Ahmedvini/fpga-atcnet/sim/db_atcnet_axi_tb.sv

// =============================================================================
// db_atcnet_axi_tb.sv  —  Lightweight sanity tests for the deployment
// wrapper rtl/db_atcnet_axi.sv. Verifies:
//
//   1. AXI-Lite reads of STATUS / CLASS work (idle-state values).
//   2. AXI-Stream handshake accepts a small burst of raw EEG beats.
//   3. AXI-Lite write to GUMBEL_LUT actually lands in the adapter's LUT
//      (read-back via observing match behaviour on the AXIS path).
//
// The full data-path is exercised by sim/db_atcnet_top_tb.sv (which goes
// through the same db_atcnet_top instance the wrapper holds); this test
// keeps the run-time short while proving the plumbing works.
// =============================================================================

`timescale 1ns / 1ps

module db_atcnet_axi_tb;

    localparam int CLK_PERIOD = 10;
    logic clk = 0;
    initial forever #(CLK_PERIOD/2) clk = ~clk;
    logic rst;

    // AXIS
    logic [31:0]  s_axis_tdata;
    logic         s_axis_tvalid;
    logic         s_axis_tready;
    logic         s_axis_tlast;
    // AXI-Lite
    logic [31:0]  s_axi_awaddr;
    logic         s_axi_awvalid;
    logic         s_axi_awready;
    logic [31:0]  s_axi_wdata;
    logic [3:0]   s_axi_wstrb;
    logic         s_axi_wvalid;
    logic         s_axi_wready;
    logic [1:0]   s_axi_bresp;
    logic         s_axi_bvalid;
    logic         s_axi_bready;
    logic [31:0]  s_axi_araddr;
    logic         s_axi_arvalid;
    logic         s_axi_arready;
    logic [31:0]  s_axi_rdata;
    logic [1:0]   s_axi_rresp;
    logic         s_axi_rvalid;
    logic         s_axi_rready;
    logic         irq_done;
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
