Ahmedvini/fpga-atcnet/(commit log)

2026-05-18 Pivot to HaLT subject-dependent variant; clean placeholder skeleton
    Architectural change from the AI team: model swapped from the subject-
    independent 4-class PhysioNet .h5 to a subject-dependent HaLT variant
    (5 input channels Gumbel-selected from 19 EEG, 600 samples @ 200 Hz,
    2 classes — right-hand fist vs left-leg ankle). Improved CBAM attention
    everywhere (no MHA); per-window weights are now INDEPENDENT, not shared.
    Removed (all dead under the new model):
    - rtl/top.sv, top_backup.sv, top_resource_eval.sv, integrated_example.sv
    (5-tap FIR demo, never DB-ATCNet)
    - rtl/conv/temporal_conv.sv, temporal_conv_backup.sv (placeholder FIR)
    - rtl/conv/dual_branch_conv.sv, channel_scale.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
    [conv2d_temporal.sv, conv2d_temporal_tb.sv, eca_attention.sv, eeg_channel_adapter.sv]
2026-05-18 Layer 1 (Conv2D temporal) PASS bit-exact on HaLT shape
    - rtl/db_atcnet_params.svh: rewritten for HaLT dims (NUM_INPUT_CH=5,
    TRIAL_SAMPLES=600, NUM_CLASSES=2, KE=64, F1=16, F2=32, POOL1=8,
    POOL2=7, NUM_WINDOWS=5, WIN_LEN=6, CBAM_RATIO=8, SPATIAL_KE=7,
    TCN depth=2 k=4, etc.)
    - scripts/q88_layer1.py: HaLT (5x600) Q8.8 reference. Loads conv2d
    weights from weights/subject_A/session_3_heldout/best_model.weights.h5.
    Synthetic deterministic 5-channel input.
    - data/golden_q88/stage_conv2d_*.hex regenerated for the new shape.
    abs_max=277 (way under Q8.8 limit of 32767), zero saturation.
    - sim/conv2d_temporal_tb.sv: NUM_EEG_CH 64->5, TRIAL_SAMPLES 640->600.
    - conv2d_temporal_tb result: 3000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
2026-05-18 Fold BatchNorm into Layer 1 Conv2D (Layers 1+2 fused, PASS bit-exact)
    BN at inference is a per-channel affine transform:
    y = gamma * (x - mean) / sqrt(var + eps) + beta
    Folding it into the preceding Conv2D collapses Layers 1+2 into a single
    hardware op (saves an RTL stage and a BRAM-traffic round trip):
    w_folded[k,f] = w[k,f] * gamma[f]/sqrt(var[f]+eps)
    bias_folded[f] = beta[f] - mean[f] * gamma[f]/sqrt(var[f]+eps)
    Changes:
    * scripts/q88_layer1.py: loads BN params from batch_normalization layer in
    .h5, computes folded weights + per-filter bias, emits both as .mem.
    Now produces stage_conv2d_bias.hex (16 Q8.8 values) alongside the
    folded stage_conv2d_weights.hex.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
2026-05-18 Layer 3 (ECA₁) PASS bit-exact + sigmoid LUT infrastructure
    Adds the gate-compute path for ECA (Efficient Channel Attention),
    shared by ECA₁ (16 ch) and ECA₂ (32 ch). Includes the universal
    sigmoid LUT used everywhere a real sigmoid is needed (ECA, CBAM
    channel gate, etc.).
    Sigmoid LUT (universal, baked into bitstream):
    * scripts/gen_sigmoid_lut.py — emits data/lut/sigmoid_q88.hex.
    Default LUT_RANGE = ±4.0, N = 1024 entries, addr-shift = 1.
    Output values: 5..251 in Q8.8 (sigmoid(±4) ≈ 0.018..0.982).
    Center entries: 0x80 = 0.5.
    * Same LUT used by Python golden (scripts/q88_eca1.py) and the
    RTL module so bit-exact is guaranteed by construction.
    ECA₁ Python re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
2026-05-18 ECA₁ complete end-to-end: GAP accumulator + gate_apply PASS bit-exact
    This closes Layer 3 (ECA₁) into a deployable three-module pipeline:
    streaming feature map → GAP → gate-compute → re-stream + gate-apply.
    Layer 1+2 output ──► gap_accumulator ──► (16-wide GAP vector)
    │ │
    │ ▼
    │ eca_attention ← weights + σ-LUT
    │ │
    │ ▼
    └─► (re-streamed) ──► gate_apply ──► (gated feature map)
    Top-level integration (next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
2026-05-18 Layer 4 (Branch A depthwise + BN folded) PASS bit-exact
    DepthwiseConv2D(kernel=(1,5), depth_multiplier=2, no bias) + BatchNorm
    collapsed into a single hardware op via BN folding. This is the first
    stage of Branch A; the gated feature map from ECA₁ collapses across
    the 5 electrodes here, producing 32 channels per time step.
    Math (matches scripts/q88_layer4.py bit-exactly):
    For each output channel i = f*D + d (f∈[0,F1), d∈[0,D)):
    y[t, i] = sat( ( sum_{c=0..4} x[t, c, f] * W_folded[c, f, d] )
    >>> FRAC_BITS + bias_folded[i] )
    BN-fold formulas reused from Layer 1+2:
    scale[i] = gamma[i] / sqrt(var[i] + eps)
    bias[i] = beta[i] - mean[i] *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
2026-05-18 Layers 5+6 (ELU LUT + temporal AvgPool) PASS bit-exact
    Two small but essential building blocks complete:
    ELU activation (Layer 5):
    * scripts/gen_elu_lut.py — 256-entry Q8.8 LUT for the negative half of
    ELU. For x≥0 the value passes through; for x<0 the address is
    ((-x) >> 3) clipped to [0, 255], indexing α(exp(x)-1). For
    alpha=1.0 (Keras default), output range is [-1.0, ~0).
    * scripts/q88_layer5.py — applies the LUT to the Branch A depthwise
    output to produce stage_branchA_elu_output.hex.
    * rtl/conv/elu.sv — parameterized N-channel ELU module with 1-cycle
    latency. Pass-through path for positives; LUT lookup for negatives
    with combinational clip + addr.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
2026-05-18 Layers 8 + 9 (Branch A: ELU on sep + AvgPool(7,1)) PASS bit-exact
    Both layers reuse existing RTL modules — Layer 8 is a second
    instantiation of rtl/conv/elu.sv (no new RTL); Layer 9 is a
    re-parameterization of rtl/conv/avg_pool_time.sv with POOL=7
    (INV_POOL=2396745, shift=24).
    New artefacts:
    * scripts/q88_layer8_9.py — applies the ELU LUT to the Branch A
    separable output (Layer 8), then runs AvgPool(7,1) on the first
    70 of 75 ELU outputs to produce 10 final Branch A outputs (Layer 9).
    The last 5 ELU outputs are dropped by Keras' valid-padding stride-7
    pool — we drive exactly 70 inputs into the RTL pool block.
    * sim/avg_pool_time_7_tb.sv — drives the 70 vectors of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
2026-05-18 Branch B (Layers 10-14) PASS bit-exact — D=4 / F_IN=64 reuse existing modules
    dwise_b: 600/600 vectors, 0 mismatches (depthwise D=4 + BN_2 folded)
    sep_b: 75/75 outputs, 0 mismatches (separable F_IN=64 + BN_4 folded)
    Same RTL modules as Branch A (depthwise_spatial.sv, conv1d_temporal.sv),
    only parameters changed. Adds q88_branchB.py Python golden chain
    and two param-specific testbenches.
2026-05-18 Layer 16 (ECA₂) PASS bit-exact — integrated GAP+Conv1D+sigmoid+gate on (10,32)
    eca2_tb: 10/10 vectors, 0 mismatches. Reuses gap_accumulator,
    eca_attention, and gate_apply modules with NUM_CH=32, KECA=3,
    INV_N=1677722 (=round(2^24/10)). Weights from layers/conv1d_1
    in the trained subject_A session_3 model.
2026-05-18 ImprovedCBAM channel attention (window 0) PASS bit-exact
    chan_tb: 6/6 vectors, 0 mismatches.
    Implements doc §5.2.1 channel-attn for ATCNet sliding window 0:
    avg+max GAP (T=6) → shared MLP Dense(4)+ReLU+Dense(32)
    → Add → sigmoid LUT → per-channel gate apply.
    Parametric (NUM_CH, T_WIN, D_RED) so the same module slots in for
    all 5 windows once dense_{i,i+5} weight files are generated.
    Two SV lessons learned and applied:
    * signed × literal needs explicit $signed cast on the literal,
    otherwise mixed-sign multiply contaminates negative inputs.
    * bit-slicing a `logic signed` strips signedness; comparisons
    against `SAT_HI[15:0]` were interpreted unsigned and falsely
    t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
2026-05-18 ImpCBAM spatial attn — Q8.8 Python golden for window 0
    Computes avg/max/stochastic descriptors over the 32 channels,
    concatenates → Conv2D(7,7,3,1) (same padding) → sigmoid LUT →
    per-time gate apply. Stochastic pool is deterministic at inference:
    probs[t,c] = |x[t,c]| / max(sum_c |x[t,c]|, eps_q88=1)
    out[t] = sum_c probs[t,c] * x[t,c]
    Conv2D with kernel (7,7) on input width 1 collapses to a 7-tap 1D
    conv over T using the kw=3 (center) column of the 2D kernel; the
    other 42 weights multiply zero-padding and are stored only for
    provenance with the trained .h5.
    Window 0 uses layers/conv2d_3. Other windows use conv2d_{3+w}.
2026-05-18 ImpCBAM spatial stochastic-pool: switch to HW-aligned formulation
    Replace 192-per-window per-element divisions with one floor-div per
    time step (inv_norm = (1<<24)/norm). Then multiply per-channel and
    sum-accumulate. Output identical to within ±1 LSB of the original
    elementwise-floor formulation, but maps cleanly to a single
    serial divider amortised over 6 timesteps per window.
2026-05-18 Add radix-2 restoring serial divider + sanity TB
    rtl/util/serial_divider.sv: unsigned floor-div with start/done
    handshake. Latency = Q_WIDTH+2 cycles. Wired up generically
    (N_WIDTH, D_WIDTH, Q_WIDTH parameters). Caller must guarantee
    denominator != 0 (e.g. stoch-pool floors |x|-sum to 1).
    Will be used by the ImpCBAM spatial attention stochastic pool
    (1 div per timestep × 6 timesteps × 5 windows = 30 divs per
    inference, ~1k cycles total — negligible at 100 MHz).
2026-05-18 TCFN (window 0) PASS bit-exact — 4 causal dilated Conv1D + BN + ELU + 3 residuals
    tcfn_tb: 6/6 vectors, 0 mismatches.
    Single FSM that reuses one F_IN-parallel MAC bank across all 4 conv
    stages (dilations 1,1,2,2). 768 cycles per conv → 3072 per TCFN.
    BN is pre-folded into the conv weights/bias in the Python golden;
    Stage 1's Residual-2 has no terminal ELU per the spec.
    Q8.8 saturation accepted (per user); both Python and RTL clip
    identically so the test stays bit-exact even when stage 2/3
    accumulator hits ±32767.
    Two traps caught:
    * Causal-conv tap convention: tap k=0 is the most recent input
    (no lookback), k=K-1 the oldest. My `back` formula was using
    (K-1-k)*d (Keras kern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
2026-05-18 Dense(2) classifier + output head (avg+argmax) PASS
    dense_tb: bit-exact logits [302, -303] for window-0 TCFN last-step input.
    head_tb : sums 5 logit pairs and argmaxes correctly (sanity, no h5 needed).
    Output head skips the explicit divide-by-N_WIN and softmax because
    argmax(mean) == argmax(sum) for monotonic positive N. Tie-break favours
    the lower class index, matching numpy's argmax default.
    [dense_classifier.sv, dense_classifier_tb.sv, output_head.sv, output_head_tb.sv]
2026-05-18 cbam_channel_attn: handle back-to-back frames + 5-window TB PASS
    Previous frame_last reset path reloaded the accumulator with the
    current x_in, leaving stale data that polluted the next frame's
    first accumulate step. New `frame_started` flag tracks per-frame
    ingestion: on the first x_valid of a fresh frame we reset acc to
    x_in; subsequent x_valid cycles accumulate; frame_last drops the
    flag so the next window starts clean again.
    chan_w0 (N_WIN=1) still bit-exact PASS.
    chan_all (N_WIN=5) NEW TB walks window_idx 0..4 through the all_chan_*.hex
    combined weight banks → 30/30 vectors, 0 mismatches across all 5 windows.
    [cbam_channel_attn.sv, cbam_channel_attn_all_tb.sv]
2026-05-18 spat + tcfn 5-window TBs PASS bit-exact
    cbam_spatial_attn: S_READY now auto-exits to S_IDLE after the last
    apply_valid pulse, so the next window's first x_valid starts a clean
    frame (previously the FSM stuck in S_READY indefinitely).
    tcfn already returns to S_IDLE via S_DONE → S_IDLE — no FSM change
    needed for back-to-back frames.
    spat_all and tcfn_all walk window_idx 0..4 through the combined
    weight banks. 30/30 vectors each, 0 mismatches.
    All four learnable blocks now verified for both single-window
    (*_w0 TBs) and 5-window (*_all TBs) operation.
    [cbam_spatial_attn.sv, cbam_spatial_attn_all_tb.sv, tcfn_all_tb.sv]
2026-05-19 5-window pipeline orchestrator — end-to-end PASS, 1-bit class out
    rtl/db_atcnet_window_pipeline.sv chains single instances of
    cbam_channel_attn, cbam_spatial_attn, tcfn, dense_classifier and
    output_head (all N_WIN=5) through an internal FSM:
    for w in 0..4:
    slice eca2_buf[w..w+5] → chan (phase 1 + phase 2)
    → spat (phase 1 + phase 2) → tcfn (push + done)
    → take TCFN last step (t=5) → dense_classifier
    → push logits to output_head with in_last on w==4
    Three intermediate buffers (chan_in/chan_out/spat_out, 6×32 Q8.8 each)
    + tcfn_last_buf (32). The window_idx is single-source-of-truth for
    weight bank selection across all blocks each pass.
    pipe_tb fires `start` o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
2026-05-19 Time-multiplexed conv1d_temporal_tm.sv — synth-fit for Z-7020/US+ — PASS
    New module sibling to conv1d_temporal.sv that reuses one F_OUT-wide MAC
    bank across KE*F_IN cycles per input sample. DSP count drops from
    F_OUT*F_IN*KE = 16,384 (impossible on either Z-7020 or US+ KU3P) to
    F_OUT = 32 (trivial on both). Per-sample latency: 514 cycles.
    Bit-exact against the existing Branch A sep golden
    (stage_branchA_sep_output.hex) using a proper valid/ready handshake.
    Original conv1d_temporal.sv left untouched for the parallel sim path.
    TB-side gotcha caught: a naive `wait (in_ready); @(posedge clk);`
    pattern lets in_valid pulse twice across one in_ready=1 window —
    DUT consumes the first, drops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
2026-05-19 Time-mux conv1d Branch B (F_IN=64) PASS bit-exact
    Same conv1d_temporal_tm.sv module re-parameterised: F_IN=64 doubles
    the cycle count to 1026/sample but keeps the DSP count at F_OUT=32.
    Bit-exact against stage_branchB_sep_output.hex (75 outputs checked).
    Confirms the time-mux engine scales: F_IN-only is the cost knob,
    not weight count.
2026-05-19 ECA₁ orchestrator (gap_acc + eca_attn + gate_apply + buffer) — PASS
    rtl/attention/eca1_pipeline.sv wraps the 3-module ECA₁ chain with an
    internal 3000×16 Q8.8 buffer so a single (16)-wide x_valid stream
    becomes a (16)-wide y_valid gated stream after one ingest + gate
    compute + replay pass. ~60 μs total at 100 MHz for 3000 frames.
    eca1_pipe_tb: 3000/3000 vectors, 0 mismatches against stage_eca1_output.hex.
    Bug caught during build: frame_last must be COMBINATIONAL (not a
    registered NBA) so gap_accumulator sees x_valid && frame_last on the
    SAME cycle as the last ingest sample. Registering it shifts it by one
    cycle past the end of the x_valid stream, gap_valid never fires, and
    the FSM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
    [eca1_pipeline.sv, eca1_pipeline_tb.sv]
2026-05-19 Branch pipeline orchestrator (dwise → ELU → pool8 → sep → ELU → pool7) PASS
    rtl/conv/branch_pipeline.sv wraps a full single-branch chain:
    Streaming (F1)-wide in → dwise+BN-fold → ELU → AvgPool(8) (75 cycles)
    → conv1d_temporal_tm (handshake) with KE same-pad (~46k cycles)
    → ELU → AvgPool(7) (10 outputs)
    branchA_tb (D=2, F2=32): 10/10 (32)-wide outputs, 0 mismatches against
    stage_branchA_pool2_output.hex. 493 μs/inference at 100 MHz (TCFN
    section is the dominant cost; in upstream this runs once per branch).
    Built on top of the verified component modules: depthwise_spatial,
    elu, avg_pool_time, conv1d_temporal_tm.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
2026-05-19 Branch B pipeline (D=4, F2=64) PASS bit-exact
    Same branch_pipeline.sv module re-parameterised: D=4, F2=64. 954 μs
    per inference (vs 493 μs for Branch A — conv1d_tm's KE*F_IN cycle
    budget doubles when F_IN goes from 32 to 64).
    10/10 vectors, 0 mismatches against stage_branchB_pool2_output.hex.
    Confirms one orchestrator module covers both branches; the synth
    plan is to instantiate two of these in parallel inside db_atcnet_upstream.
2026-05-19 eca1_pipeline: feed gap_acc on first sample too — ECA₂ PASS via reuse
    Bug: gap_accumulator was gated by `state == S_INGEST && x_valid`, but
    the FIRST sample is consumed during the S_IDLE → S_INGEST transition,
    so gap_acc was missing it. For ECA₁ (N=3000) the resulting 1/3000 mean
    shift rounded to the same Q8.8 LSB and the test passed; for ECA₂
    (N=10) the 1/10 shift produced mismatches on every output.
    Fix: gate gap_acc with `(state == S_IDLE || state == S_INGEST) && x_valid`.
    The same eca1_pipeline.sv module instantiated with NUM_CH=32,
    N_FRAMES=10, INV_N=1677722 now produces ECA₂ output bit-exactly:
    eca2_pipe_tb 10/10, 0 mismatches.
    ECA₁ retest still 3000/3000 PASS.
    [eca1_pipeline.sv, eca2_pipeline_tb.sv]
2026-05-19 Post-ECA₁ orchestrator (branchA + branchB + sat_add + ECA₂) PASS bit-exact
    rtl/db_atcnet_post_eca1.sv wires:
    Streaming ECA₁-gated input → 2× branch_pipeline (D=2 + D=4 in parallel)
    → sat_add (10 cycles) → eca1_pipeline (NUM_CH=32, N_FRAMES=10 = ECA₂)
    → (10 × 32) eca2_buf
    Verified end-to-end: drive stage_eca1_output.hex through the module,
    compare resulting eca2_buf against stage_eca2_output.hex. 0 mismatches.
    Total latency: 954 μs at 100 MHz (Branch B's conv1d_tm dominates).
    This closes the remaining gap between the upstream stages we already
    verified one-at-a-time and the existing db_atcnet_window_pipeline.
    Once Conv2D and ECA₁ are wrapped (one more orchestrator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
2026-05-19 Conv2D + ECA₁ wrapper PASS bit-exact — raw EEG → ECA₁-gated stream
    rtl/db_atcnet_conv2d_eca1.sv chains conv2d_temporal + eca1_pipeline:
    raw EEG (1 sample per cycle, electrode index, T_TOTAL × C_IN cycles)
    → conv2d_temporal (KE=64 same-pad, drops first KE-1 warmup outputs)
    → eca1_pipeline (NUM_CH=16, N_FRAMES=3000)
    → (16)-wide gated stream + frame_last marking C_IN-th electrode
    c2e1_tb: 3000/3000 vectors, 0 mismatches against stage_eca1_output.hex.
    Total ~63 μs at 100 MHz.
    Bridges the raw-EEG side to the existing db_atcnet_post_eca1 module.
    Together they cover the entire Conv2D → ECA₁ → branches → ECA₂ chain
    that produces the eca2_buf the window pipeline co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
2026-05-19 Full end-to-end RTL inference (raw EEG → 1-bit class) PASS bit-exact
    rtl/db_atcnet_top.sv stitches the three integration layers:
    raw EEG stream (T_TOTAL × C_IN = 663 × 5 = 3315 cycles)
    → db_atcnet_conv2d_eca1 (Conv2D + ECA₁ gate)
    → db_atcnet_post_eca1 (Branch A + B + sat_add + ECA₂)
    → db_atcnet_window_pipeline (5 sliding windows + ImpCBAM + TCFN +
    Dense + sum-argmax head)
    → 1-bit class output, `done` pulse.
    top_tb drives stage_conv2d_input.hex (Subject A session 3 trial),
    waits up to 400k cycles. Result:
    class_out = 0 (Right Hand fist), $finish at 1,154,535 ns
    = 115,453 cycles ≈ 1.15 ms at 100 MHz.
    Bit-exact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
2026-05-19 AXI4-Lite weight loader + weight_bank — sanity test PASS
    rtl/weights/axi_lite_weight_loader.sv: AXI4-Lite slave shim that turns
    each PS write into a one-cycle (wr_en, wr_addr, wr_data) pulse on a
    broadcast interface. No internal storage — pure protocol.
    rtl/weights/weight_bank.sv: generic Q8.8 weight RAM with byte-address
    decoding, PACK_2 (two Q8.8 entries per 32-bit AXI word), and optional
    $readmemh INIT_FILE for sim. Each block in the model owns one or more
    instances of this and snoops the broadcast write interface, self-
    decoding its own BASE_ADDR/DEPTH range.
    axil_tb: drives 3 AXI-Lite writes and verifies the corresponding
    indices in the weight bank's mem[] array. PASS. Foundation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
2026-05-19 Gumbel 19→5 channel adapter with runtime-loadable LUT — PASS
    rtl/window/gumbel_channel_adapter.sv: tiny module that translates a
    streaming 19-channel raw EEG feed into the 5-channel stream
    db_atcnet_top expects, using a 5-entry electrode-index LUT.
    Default LUT is Subject A session 3: [9, 11, 12, 14, 3]
    (O2, F8, T3, T5, F4). PS overrides via the same AXI-Lite broadcast
    write interface used by weight_bank — 3 × 32-bit words at
    LUT_BASE_ADDR = 0x2000 cover the 5 LUT entries (PACK_2).
    Duplicate LUT entries are supported (e.g. Subject A fold-0 selects
    [11, 3, 5, 9, 9]): when one raw electrode matches multiple LUT
    positions, the adapter fans out N outputs over N consecutive cycles
    via a m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
2026-05-19 Deployment scaffold: db_atcnet_axi wrapper + PS demo + weight packer
    Wraps the bit-exact-verified db_atcnet_top with the two Zynq buses
    needed to deploy:
    * AXI4-Stream slave (s_axis_*) — PS streams raw 19-channel EEG, one
    (electrode | sample) packed beat per cycle. The internal Gumbel
    19→5 channel adapter then feeds db_atcnet_top.
    * AXI4-Lite slave (s_axi_*) — used both to broadcast-write weights
    at boot AND to read STATUS (busy/done) + CLASS mailbox afterwards.
    Address map (rtl/db_atcnet_axi.sv defaults):
    0x0000_0000..0x0000_1FFF weight bank writes
    0x0000_2000..0x0000_200B Gumbel 19→5 LUT
    0x0000_F000 STATUS [1]=done [0]=busy
    0x0000_F004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
2026-05-19 Synth-fit script for Z-7020 / Zynq Ultrascale+
    synth/synth_fit.tcl: vivado-mode-batch script that synthesizes
    db_atcnet_axi out-of-context against a target part and dumps
    utilization + timing reports under build/synth_<part>/.
    Usage:
    vivado -mode batch -source synth/synth_fit.tcl \
    -tclargs xc7z020clg400-1 # PYNQ-Z2
    vivado -mode batch -source synth/synth_fit.tcl \
    -tclargs xczu3eg-sbva484-1-e # Ultra96
    Note: post-synth Vivado may flag the 768k-register `buf_mem_reg` array
    inside eca1_pipeline.sv as a "3D-RAM" runtime warning — that's the
    96 KB ECA₁ replay buffer; on real silicon it folds to ~22 BRAM18s
    (well within Z-7020's 140-BRAM budget and tr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
2026-05-19 Deployment notes for ZCU104 (XCZU7EV-2FFVC1156)
    docs/DEPLOY_ZCU104.md walks through the full bring-up:
    - Q8.8 weight generation + bit-exact sim regression suite.
    - out-of-context synthesis fit + resource budget.
    - Vivado IPI integration (PS + AXI-DMA + GIC connections).
    - PS-side Vitis build + per-subject changeover.
    Latency budget table: 1.15 ms PL compute + ~3 ms AXIS push +
    1 AXI-Lite read ≈ 5 ms per trial — 1 sample of jitter at 200 Hz EEG.
2026-05-19 .gitignore: cover synth outputs, Vitis workspace, backup journals
    Adds explicit patterns for items that landed loose during this
    session's synth/sim work or that will land once you start the Vivado
    IPI + Vitis flow:
    - /build/ + /synth/build/ (synth_fit.tcl output dirs)
    - *.backup.jou / *.backup.log (vivado_<pid>.backup.* + xsim_<pid>.backup.*)
    - work.* (xsim binary databases beyond *.wdb)
    - *.dcp / *.rpt / *.rpx (post-synth checkpoints + reports)
    - hs_err_pid*.log (JVM crash logs Vivado drops on OOM)
    - .metadata / .settings / .cproject / .project / Debug / Release / *.elf
    (Vitis bare-met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
2026-05-19 Add docs/IMPLEMENTATION.md — engineering reference for paper writing
    Comprehensive implementation document covering:
    * Problem statement, scope, and accuracy reference (95.72% Subject A)
    * Q8.8 fixed-point methodology (BN folding, reciprocal-multiply,
    LUTs, stochastic pool, quantization behavior)
    * Module hierarchy + per-module resource patterns
    * Single-instance + N_WIN-banked time-multiplex design decision
    * Verification methodology (Python golden + bit-exact TBs, 26 PASS)
    * 9 notable bugs caught during development (table form, citable)
    * Performance: 1.15 ms / inference @ 100 MHz, per-stage breakdown
    * ZCU104 resource estimate + Z-7020 viability discussion
    * End-to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
2026-05-26 Add hex files for convolutional layers and ECA weights
    - Created stage_conv2d_bias.hex with bias values for the convolutional layer.
    - Created stage_conv2d_weights.hex containing weights for the convolutional layer.
    - Added stage_eca1_weights.hex with weights for the first ECA stage.
    - Added stage_eca2_weights.hex with weights for the second ECA stage.
2026-05-30 Remove unused weight and bias files for convolutional and ECA stages to streamline the repository.
2026-05-30 Add implementation and bitstream generation scripts for db_atcnet_axi
    - Created `impl_fit.tcl` for full Vivado implementation flow (synthesis, optimization, placement, physical optimization, routing) with detailed reporting.
    - Added `write_bitstream.tcl` to open the post-route checkpoint and generate the bitstream and hardware handoff files.
    - Introduced `bloat_44.plot` for visualizing data from `bloat_44.dat`.
    - Added `iter_100_CongestedCLBsAndNets.txt` to document congested CLB tiles and nets.
2026-06-01 Add ESP32 motor controller implementation for DB-ATCNet BCI
2026-06-03 Add UART bridge and hex conversion scripts for EEG data processing
2026-06-04 Update ESP32 motor controller code for S3 compatibility and add power tree build guide
2026-06-04 Add ZCU106 support: create new constraints and retarget scripts for UART1
2026-06-04 Add ZCU106 implementation results documentation
    - Documented post-implementation metrics including timing closure, resource utilization, power analysis, routed netlist, and differences from the Semester 1 prototype.
    - Included reference figures for thesis and detailed tables for clarity.
    - Established authoritative source for Chapter 8 citations in the thesis.
2026-06-15 Add thesis chapters on hardware design and FPGA deployment for BCI project
    - Introduced Chapter 7 detailing hardware design and circuit implementation, including subsystems, signal path analysis, and component analysis.
    - Added Chapter 8 focusing on FPGA deployment and hardware acceleration, utilizing existing materials and enhancing with project-specific details.
    - Established a comprehensive structure for both chapters, ensuring adherence to IEEE citation style and technical accuracy.
    - Included placeholders for missing figures and emphasized the importance of referencing actual project materials throughout.
2026-06-15 Fix UART baud rate configuration for ZCU106 to reduce framing errors
    [main.c]
2026-06-16 Add HOMING state check to handleByte function to prevent premature servo retargeting
    [db_atcnet_esp32.ino]
2026-06-26 Remove obsolete documentation and figures related to ZCU106 implementation, including circuit schematics, power summaries, and utilization reports. Update ESP32 servo control logic for improved funct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
